pedrospoljaric/processor/readme.md

# Architecture and processor

Check report.pdf for detailed descriptions about the design of the computer architecture and the implementation of the processor. (pt-BR)
